EchoMAV/docs/docs/index.md

# EchoMAV Documentation

Welcome to the EchoPilot AI Technical Library. Please find the quick links below to get started:

**[EchoPilot AI Hardware Overview](echopilot_ai.md)**  

**[Building ArduPilot for the EchoPilot AI](build_ardupilot.md)**

**[Building PX4 for the EchoPilot AI](build_px4.md)**

**[Building L4T (Orin NX or Orin Nano) for the EchoPilot AI](compile_l4t_orin.md)**

**[Building L4T (Xavier NX) for the EchoPilot AI](compile_l4t.md)**

**[Building L4T (Nano) for the EchoPilot AI](compile_l4t_nano.md)**
