EchoMAV/docs/docs/ap_simulator.md

## How to set up an Ardupilot simulator

### If you are running on windows, you will first need to install WSL1 (Windows Subsystem for Linux version 1)

Click Start, type PowerShell, and then right click "PowerShell" and "Run As Administrator"
```
dism.exe /online /enable-feature /featurename:Microsoft-Windows-Subsystem-Linux /all /norestart
```
Restart your system

Open PowerShell again
```
wsl --set-default-version 1
wsl --install -d Ubuntu-20.04
```

Once installation completes, you should be able to run Ubuntu, Click Start, type Ubuntu, and then click Ubuntu on Windows. The first time it runs you will create a username and password to use withing Ubuntu. The instructions below pick up at the point you have a command prompt.

### Install Ardupilot and run the simulator

Get prereqs:
```
sudo apt-get update
sudo apt-get install git
sudo apt-get install gitk git-gui
```
Clone repo:
```
git clone https://github.com/ArduPilot/ardupilot.git
cd ardupilot
git checkout Plane-4.3.1
git submodule update --init --recursive
```
Set up build environment:
```
Tools/environment_install/install-prereqs-ubuntu.sh -y
```
Reload the path:
```
. ~/.profile
```
Run the simulator, which will build the code the first time:
```
cd ArduPlane
../Tools/autotest/sim_vehicle.py -j4 -f quadplane
```
Once the simulator is built and running (it will take several minutes the first time you do it), you will need to set 2 key parameters by typing the following:
```
param set Q_MAV_TYPE 20
param set BRD_SERIAL_NUM 4097
```
At this point, you have ArduPlane 4.3.1 running and it will by default open a port on localhost:14550. Run the GCS and it should automatically connect to the simulator. Windows may ask you for permission to open the port, be sure and ALLOW the connection.

You may stop the simulator using ```Ctrl-C```  
#### Be sure the simulator is not running before connecting to an actual vehicle

## If you to start up the simulator at a custom location
You will need to edit the /Tools/autotest/locations.txt file  
If the simulator is running, stop it and exit using ```Ctrl-C```  
Install a simple text editor called `nano` using:
```
sudo apt-get install nano
```
Edit the `locations.txt` file
```
nano ~/ardupilot/Tools/autotest/locations.txt
```
use the arrow keys to scroll down and add a new entry:
```
NAME=Lat,Lon,Altitude,0
```
Lat and Lon are decimal degrees, altitude is meters above sea level. I'm not sure what the last 0 is for, so just leave it 0. For example, Knoxville would be:
```
Knoxville=35.92310,-84.22301,900,0
```
Save the file and exit
```
Ctrl-o <enter>
Ctrl-x
```
You may now start the simulator specifying the name of your new location
```
cd ~/ardupilot/ArduPlane
../Tools/autotest/sim_vehicle.py -j4 -f quadplane -L <YOUR LOCATION>
```
For example, to start the Knoxville location would be 
```
../Tools/autotest/sim_vehicle.py -j4 -f quadplane -L Knoxville
```
