EchoMAV/docs/docs/assets/carrierthermaltop.jpg

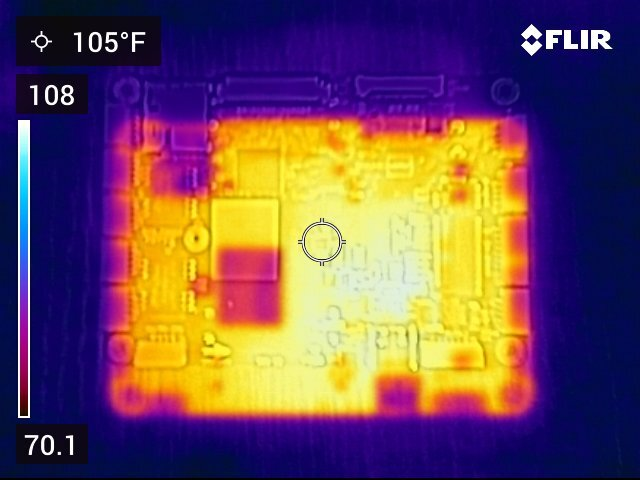
docs/assets/carrierthermaltop.jpg
