EchoMAV/docs/docs/assets/mk1fan.jpg

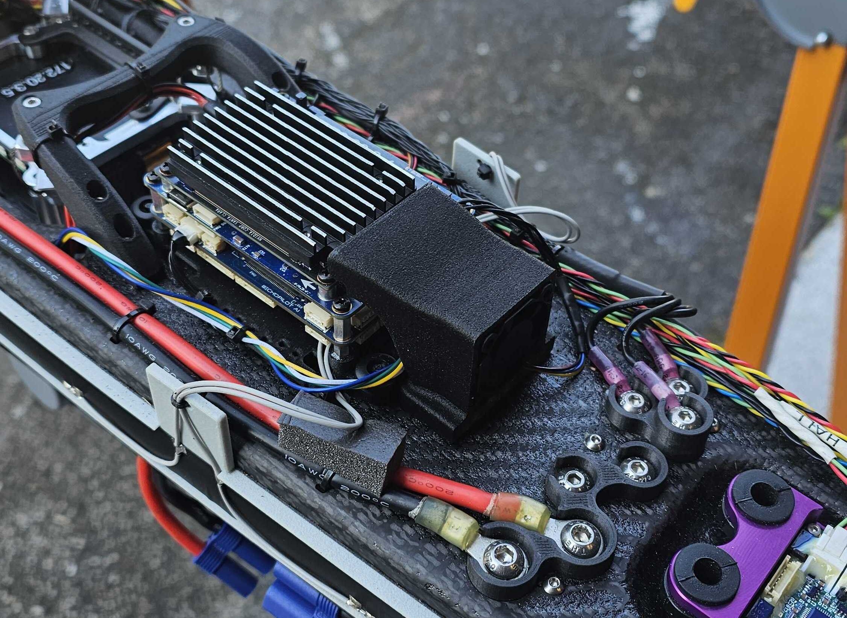
docs/assets/mk1fan.jpg
