EchoMAV/docs/docs/assets/thermalbottom.jpg

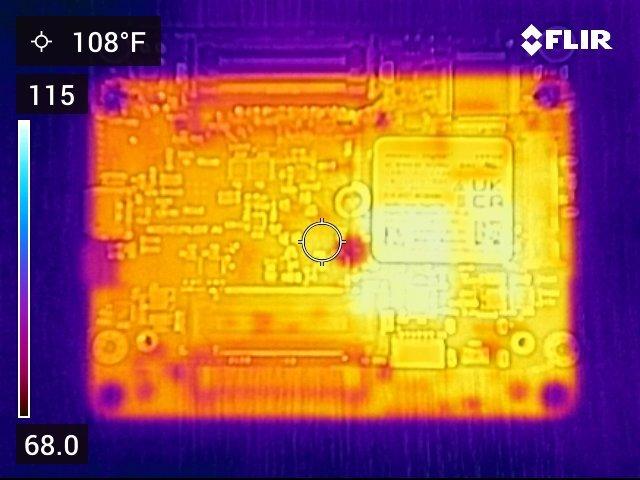
docs/assets/thermalbottom.jpg
