EchoMAV/docs/docs/assets/thermaltop.jpg

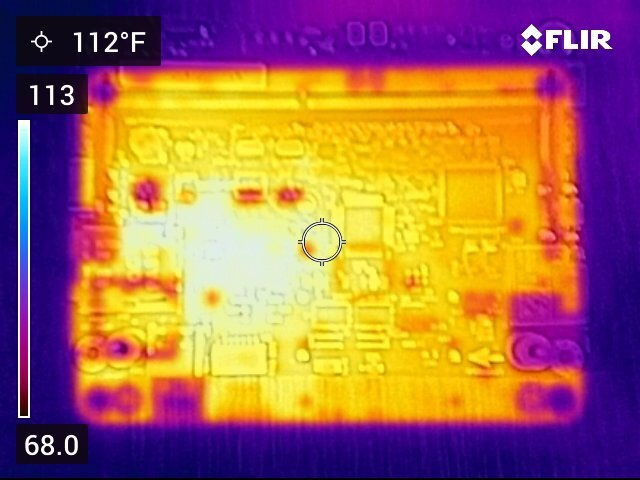
docs/assets/thermaltop.jpg
