EchoMAV/docs/docs/assets/PWM_BREAKOUT.step

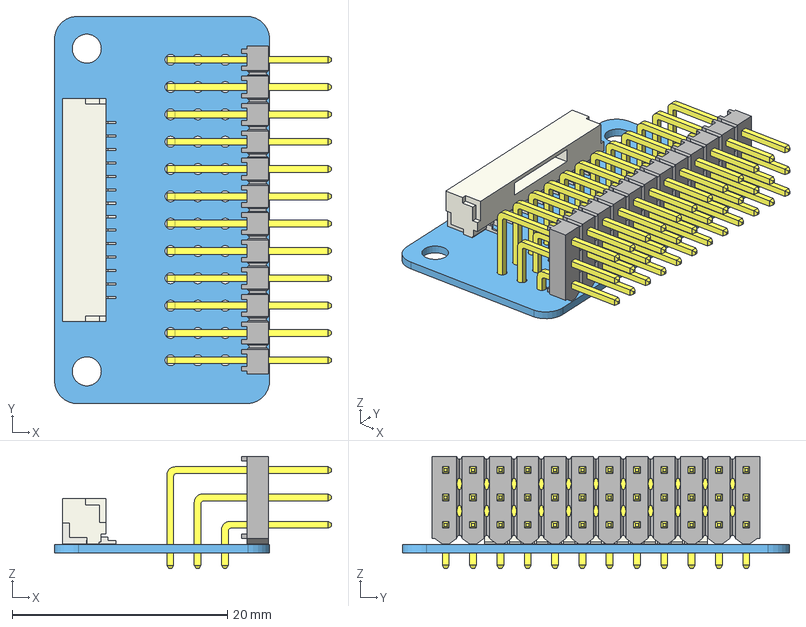
[picture p27: CAD file, 2026-07-28]
docs/assets/PWM_BREAKOUT.step
25.7 x 36.0 x 10.4 mm
echopilot_pwm_breakout PCB
