EchoMAV/docs/echopilot_carrier_1c.stl

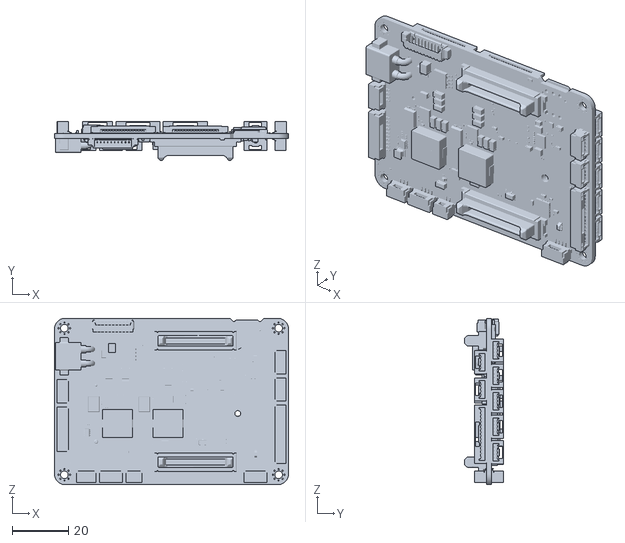
[picture p28: CAD file, 2025-11-04]
echopilot_carrier_1c.stl
83.0 x 13.8 x 59.0
