EchoMAV/docs/docs/assets/echopilot_ai.stl

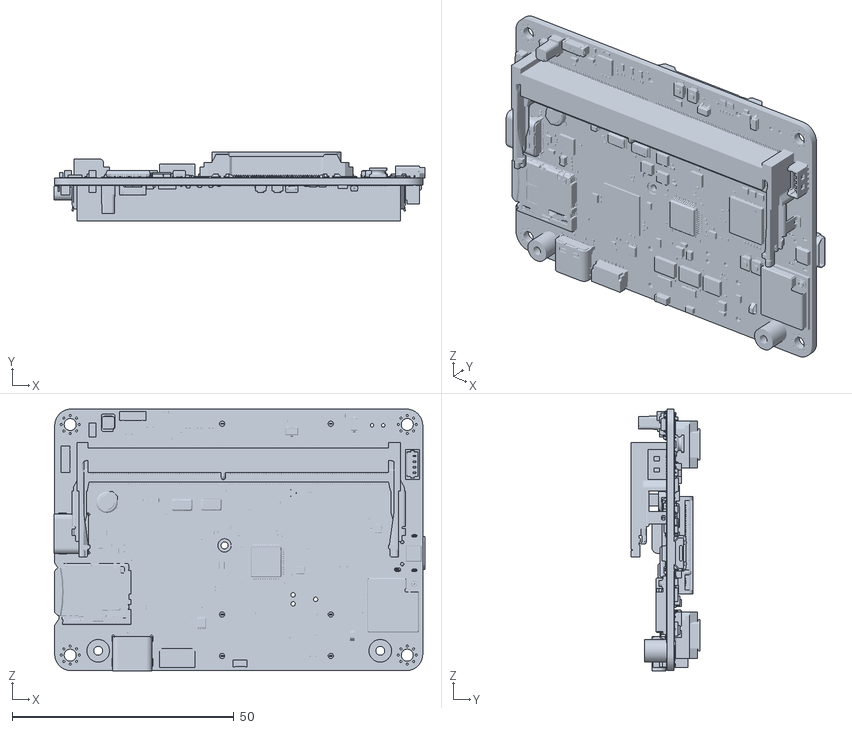
[picture p29: CAD file, 2025-11-04]
docs/assets/echopilot_ai.stl
83.6 x 15.6 x 59.1
