EchoMAV/docs/(list of files, cad)

Other CAD files:
docs/assets/echopilot_pwm_breakout.step
