EchoMAV/docs/(threads)

Thread 1 (2025-01-29):

Compile Orin NX docs instruct to download BSP sources but it is never used

nabeelsherazi, 2025-01-29:
Hi there!

I wanted to point out that the docs for compiling L4T for the Orin NX instruct to download three files:

> Next you will need to download three packages from Nvidia: [Driver Package (BSP), Sample Root Filesystem and Driver Package (BSP) Sources](https://developer.nvidia.com/embedded/jetson-linux-r3643).

But the "Driver Package (BSP) Sources" are never used. Wanted to double check that this is an error and not a missing step in the documentation.

Thank you!
