EchoMAV/docs/docs/assets/echopilot_ai_carrier_rev1d.pdf

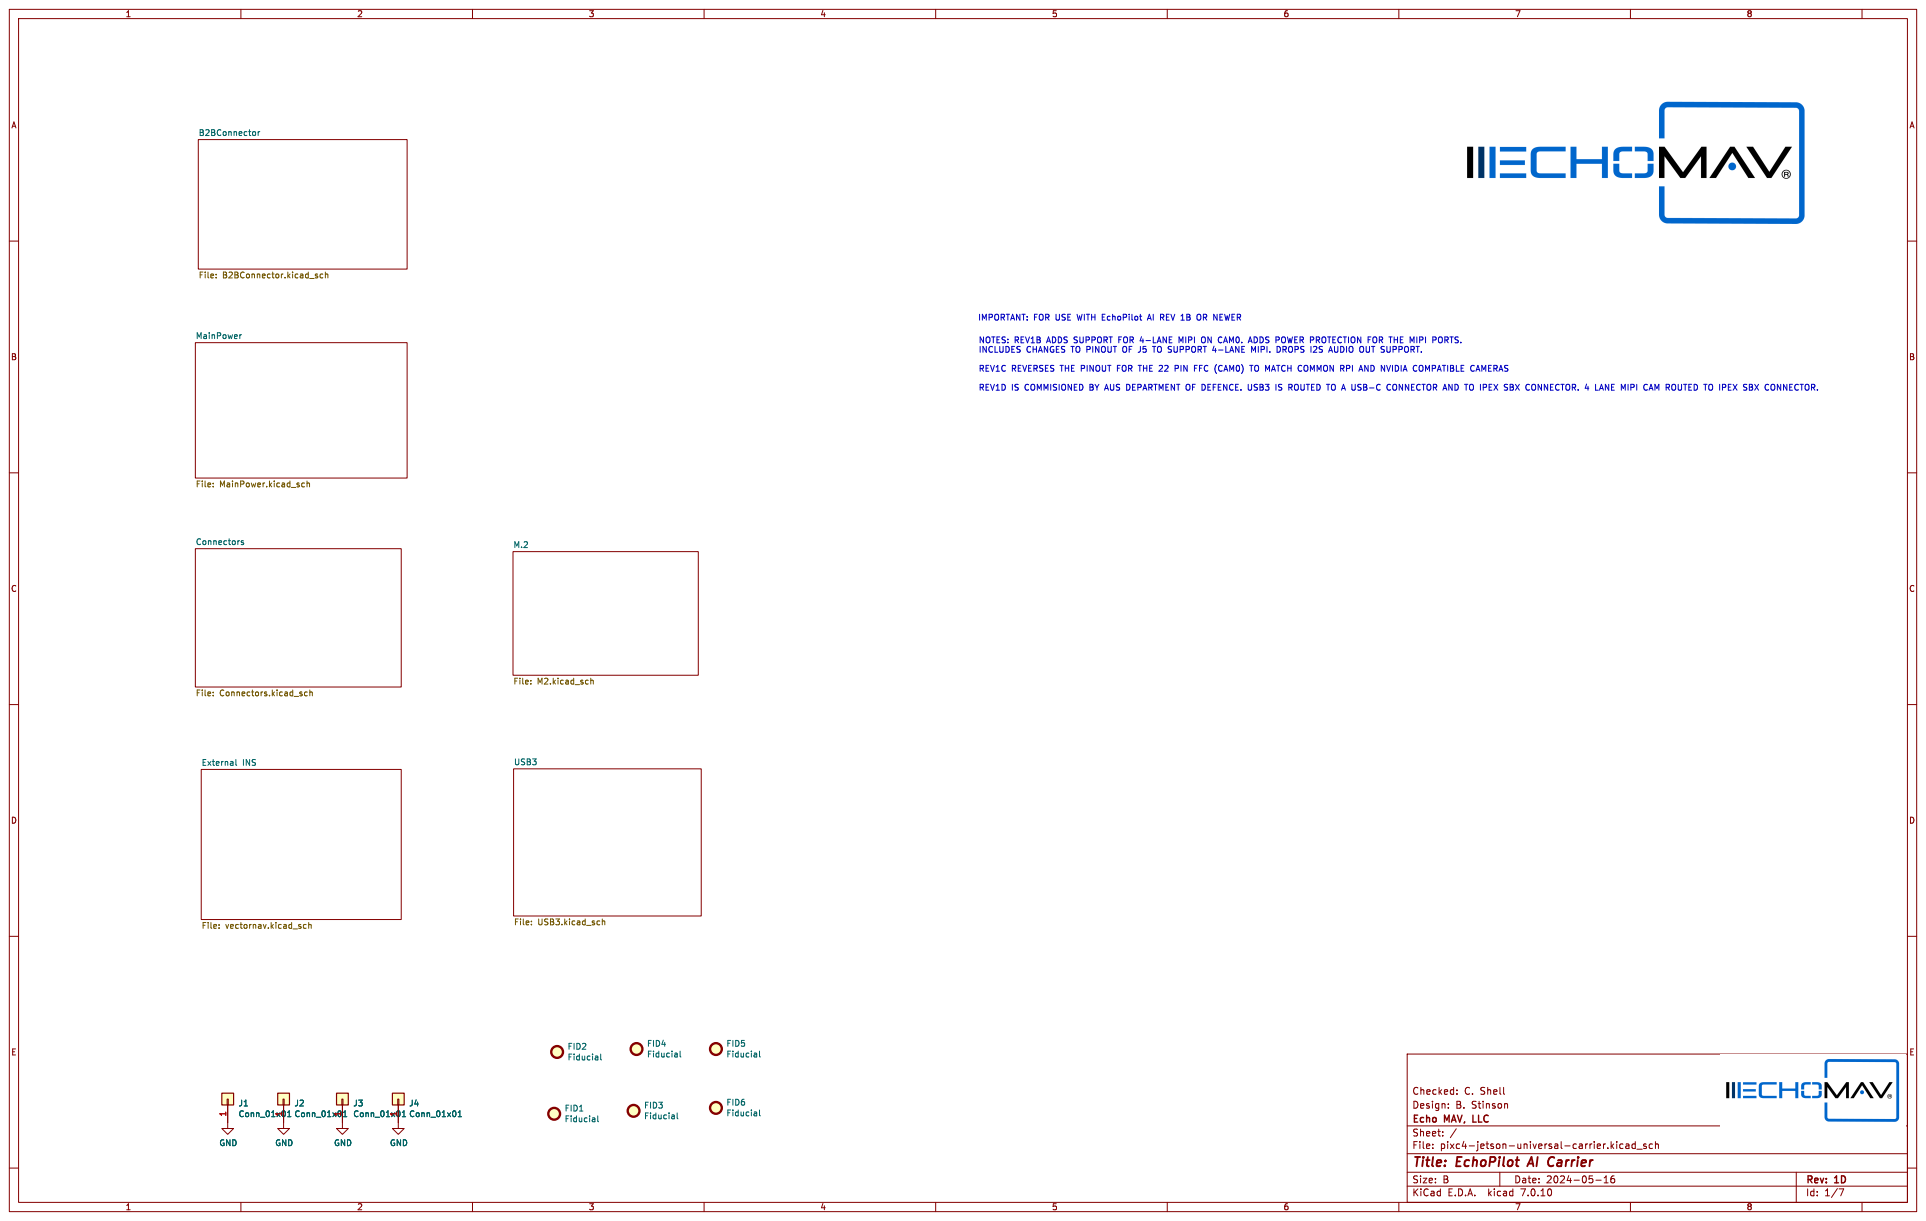
[picture p33: page 1]

B2BConnector File: B2BConnector.kicad_sch MainPower File: MainPower.kicad_sch Connectors File: Connectors.kicad_sch External INS

NOTES: REV1B ADDS SUPPORT FOR 4-LANE MIPI ON CAM0. ADDS POWER PROTECTION FOR THE MIPI PORTS.
INCLUDES CHANGES TO PINOUT OF J5 TO SUPPORT 4-LANE MIPI. DROPS I2S AUDIO OUT SUPPORT. REV1C REVERSES THE PINOUT FOR THE 22 PIN FFC (CAM0) TO MATCH COMMON RPI AND NVIDIA COMPATIBLE CAMERAS REV1D IS COMMISIONED BY AUS DEPARTMENT OF DEFENCE. USB3 IS ROUTED TO A USB-C CONNECTOR AND TO IPEX SBX CONNECTOR. 4 LANE MIPI CAM ROUTED TO IPEX SBX CONNECTOR.

Design: | B E.D.A. | B. Stinson Checked: C. Shell | kicad 7.0.10 Size: Rev: 1D | E Date: 2024-05-16 KiCad

MAV, LLC Id: 1/7 Title: EchoPilot AI Carrier File: pixc4-jetson-universal-carrier.kicad_sch Sheet: / Echo

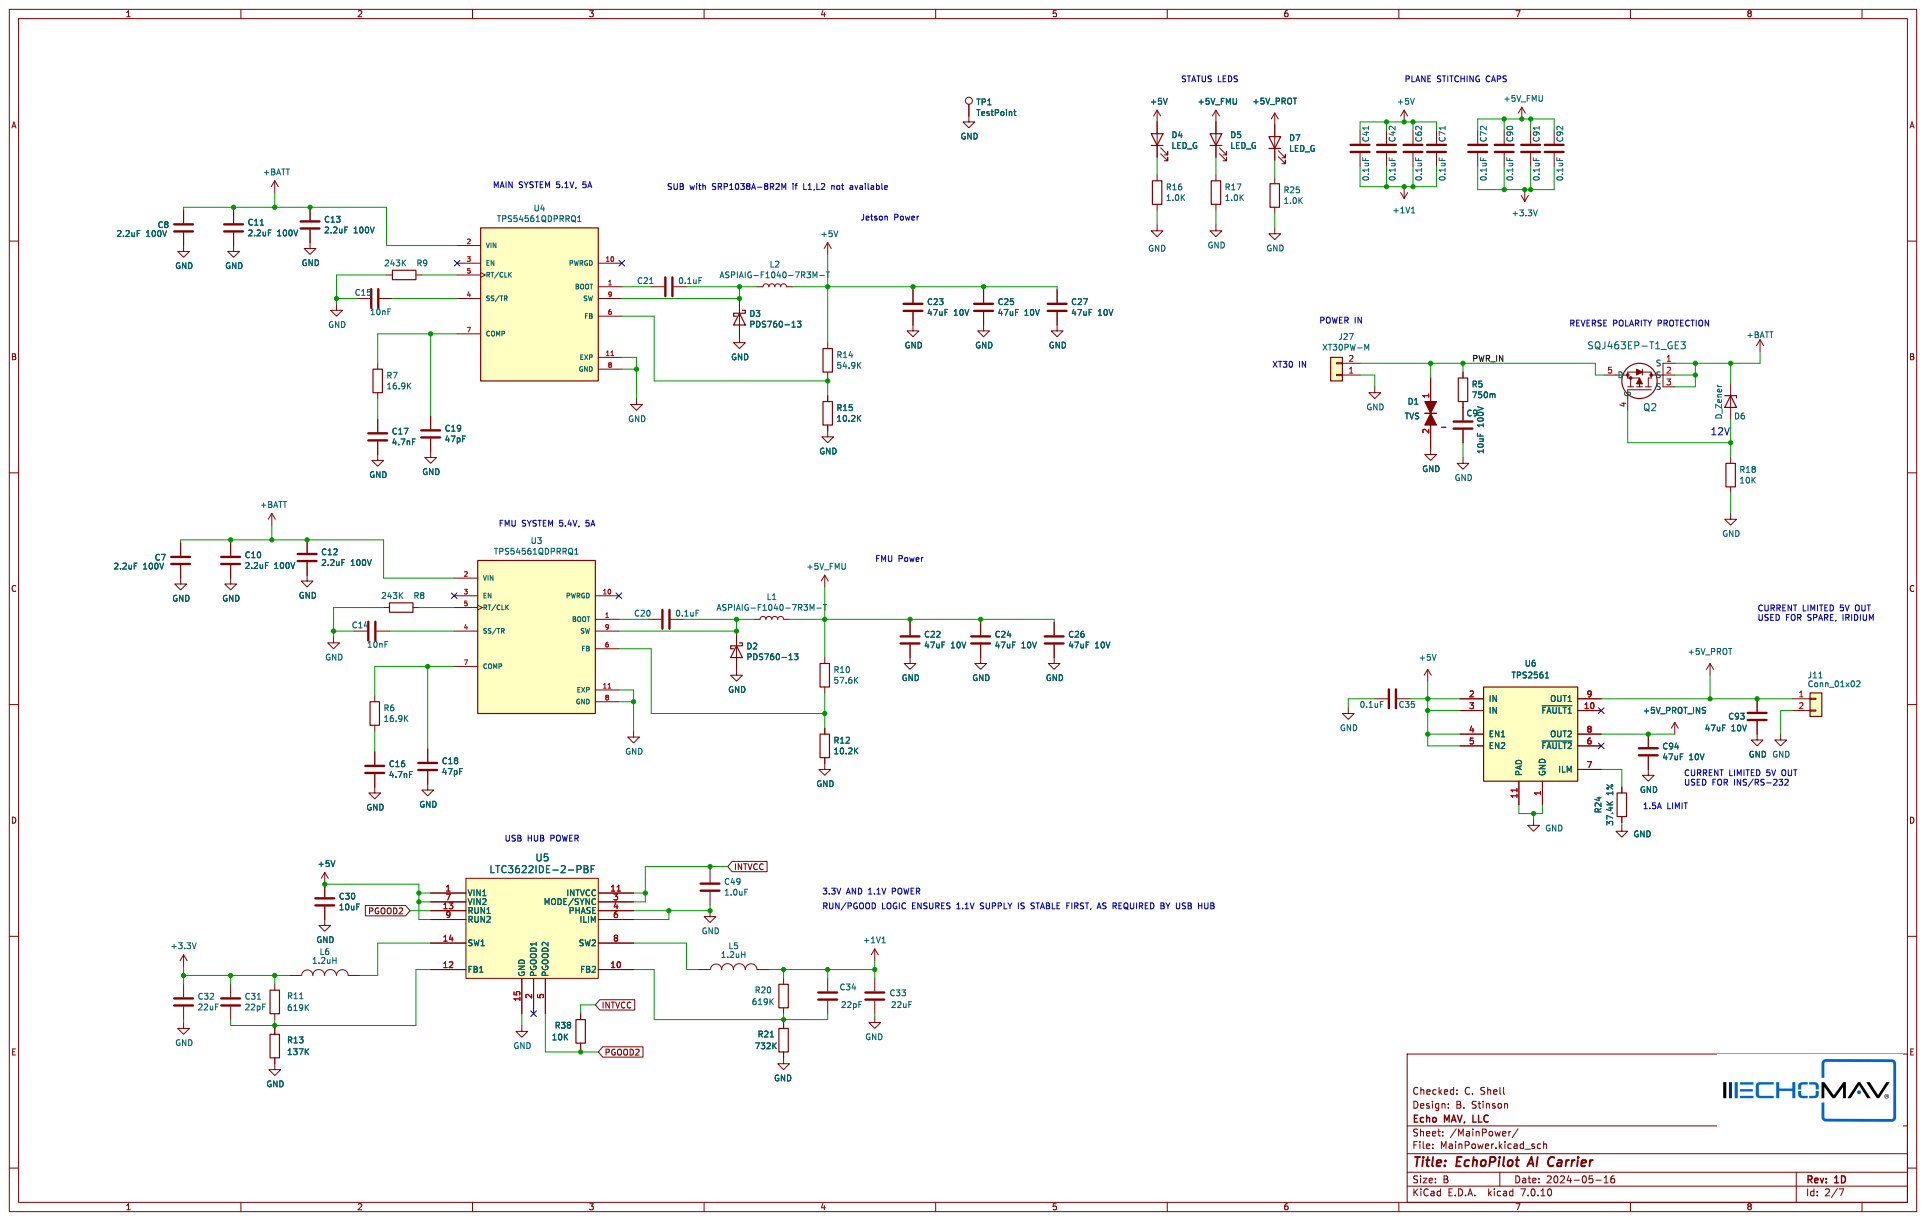
[picture p34: page 2]

3.3V AND 1.1V POWER
RUN/PGOOD LOGIC ENSURES 1.1V SUPPLY IS STABLE FIRST, AS REQUIRED BY USB HUB

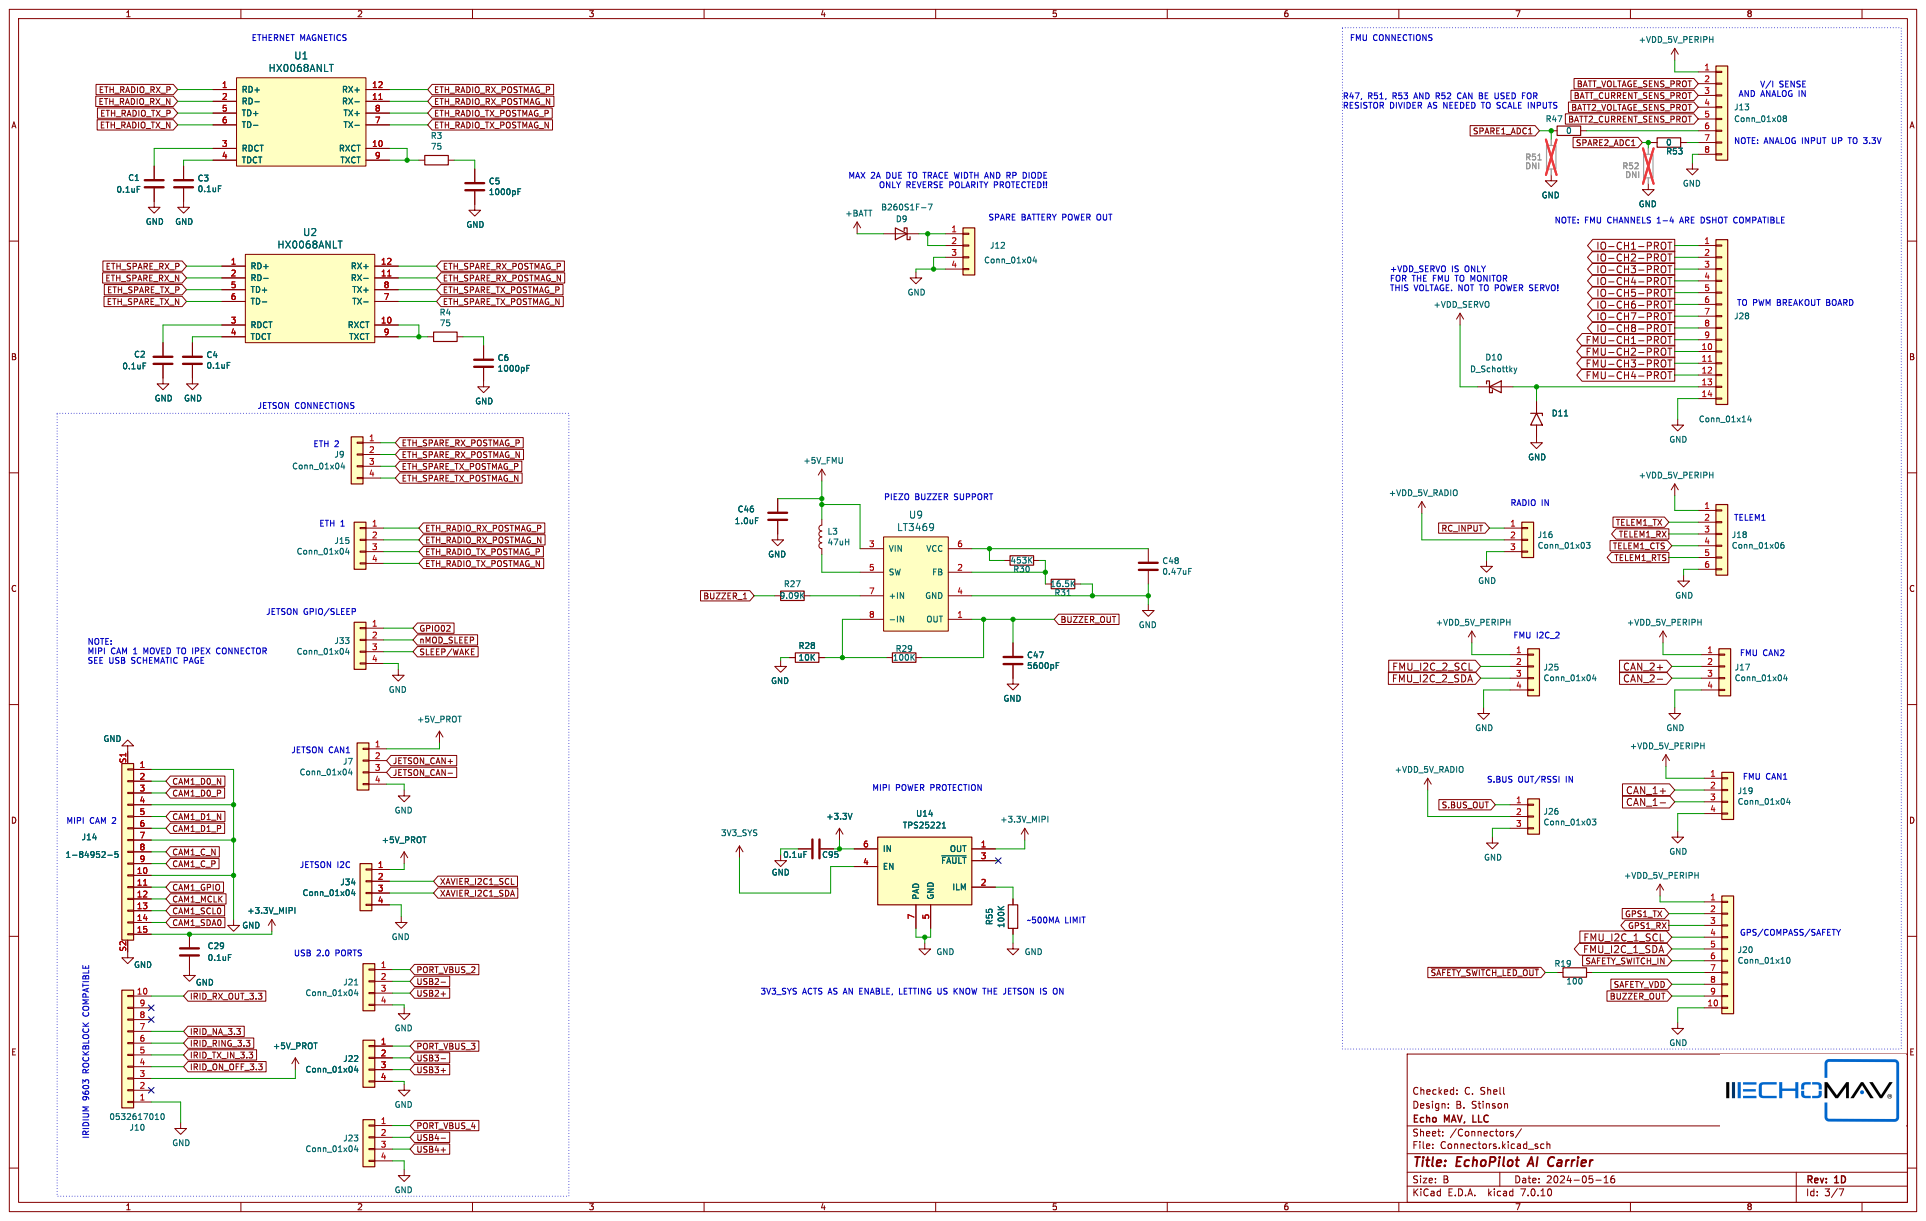
[picture p35: page 3]

RESISTOR DIVIDER AS NEEDED TO SCALE INPUTS

NOTE: ANALOG INPUT UP TO 3.3V

SPARE BATTERY POWER OUT C3

FOR THE FMU TO MONITOR

TO PWM BREAKOUT BOARD

JETSON CAN1 MIPI CAM 2 NOTE: MIPI CAM 1 MOVED TO IPEX CONNECTOR

SEE USB SCHEMATIC PAGE

~500MA LIMIT MIPI POWER PROTECTION

3V3_SYS ACTS AS AN ENABLE, LETTING US KNOW THE JETSON IS ON

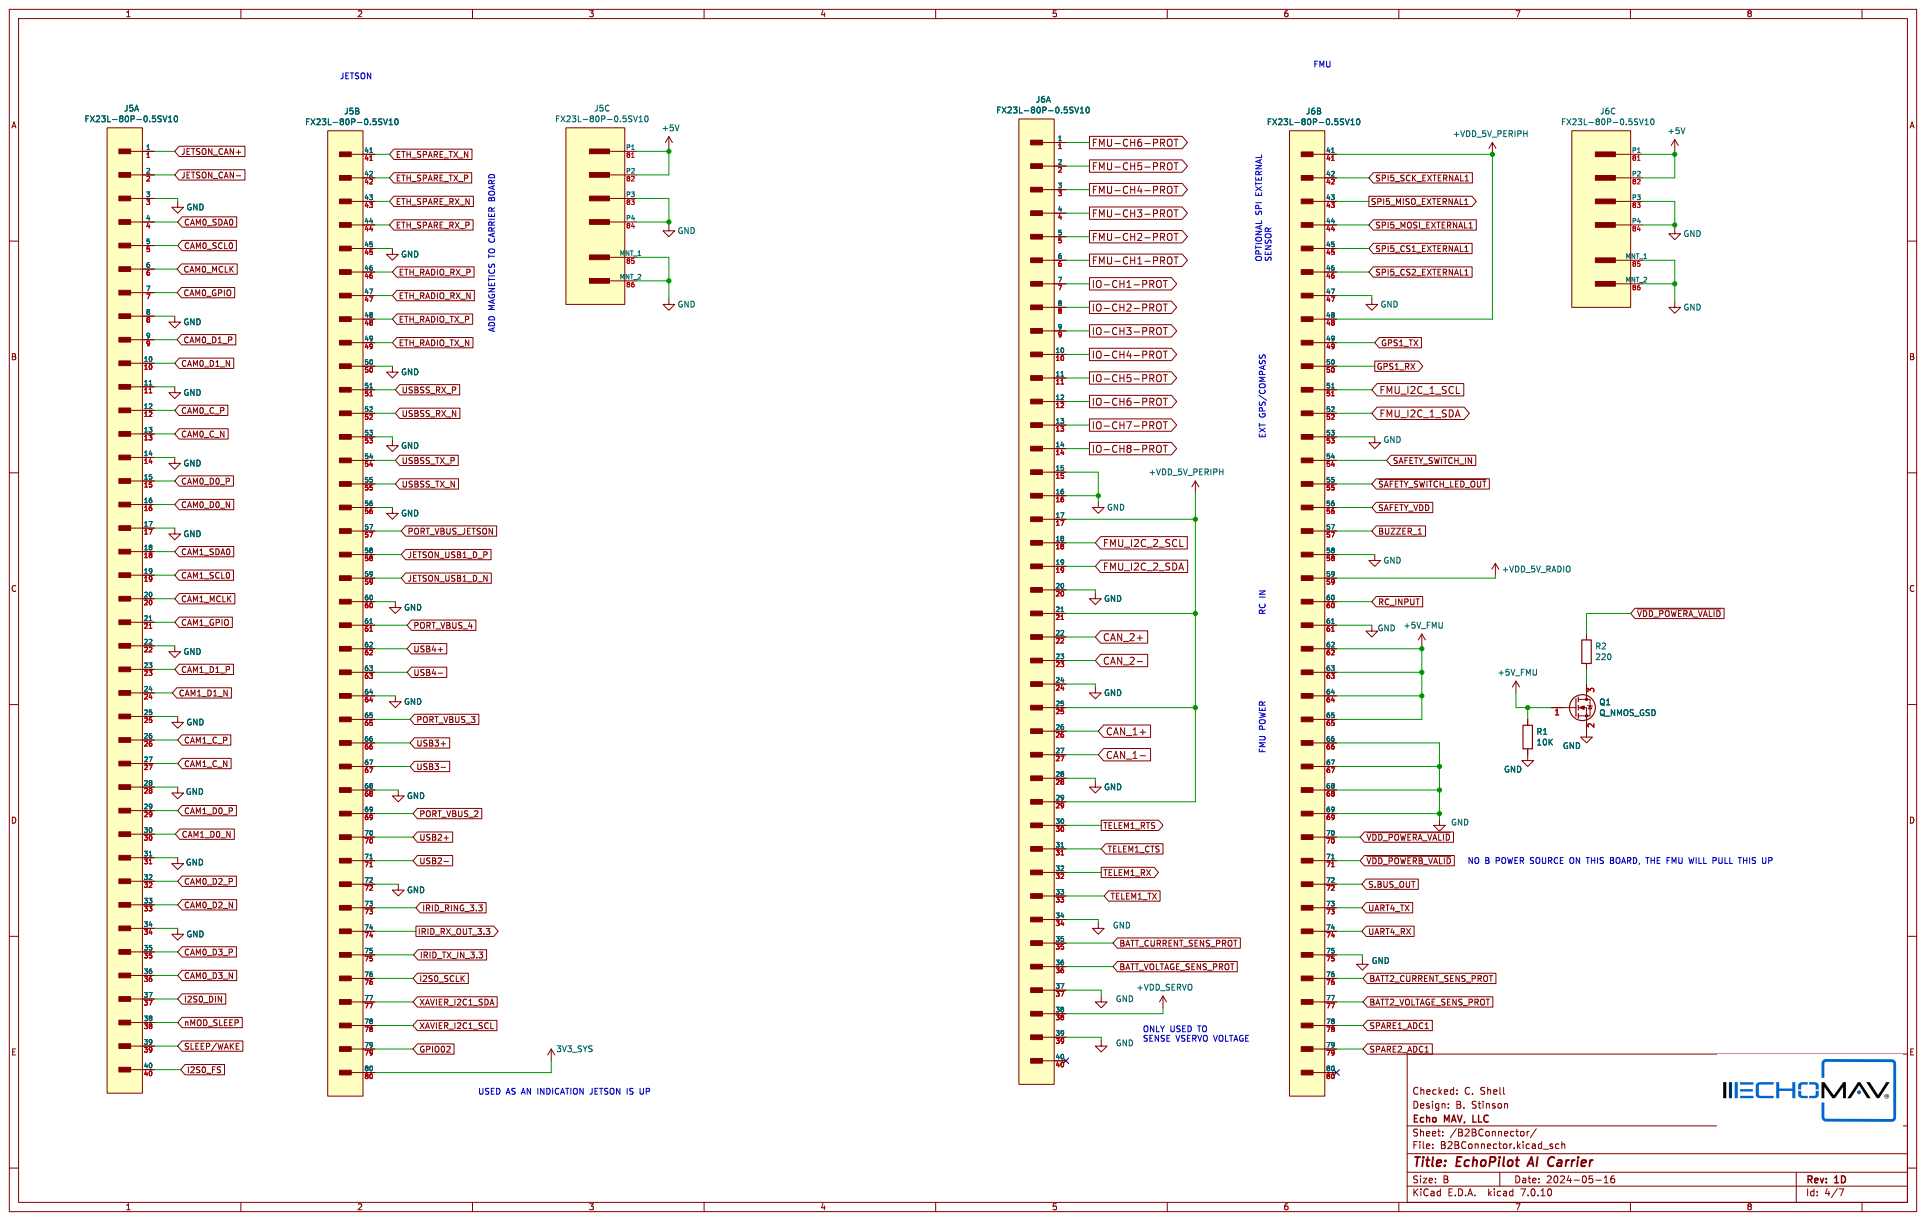
[picture p36: page 4]

+5V_FMU
SENSE VSERVO VOLTAGE FMU POWER

NO B POWER SOURCE ON THIS BOARD, THE FMU WILL PULL THIS UP

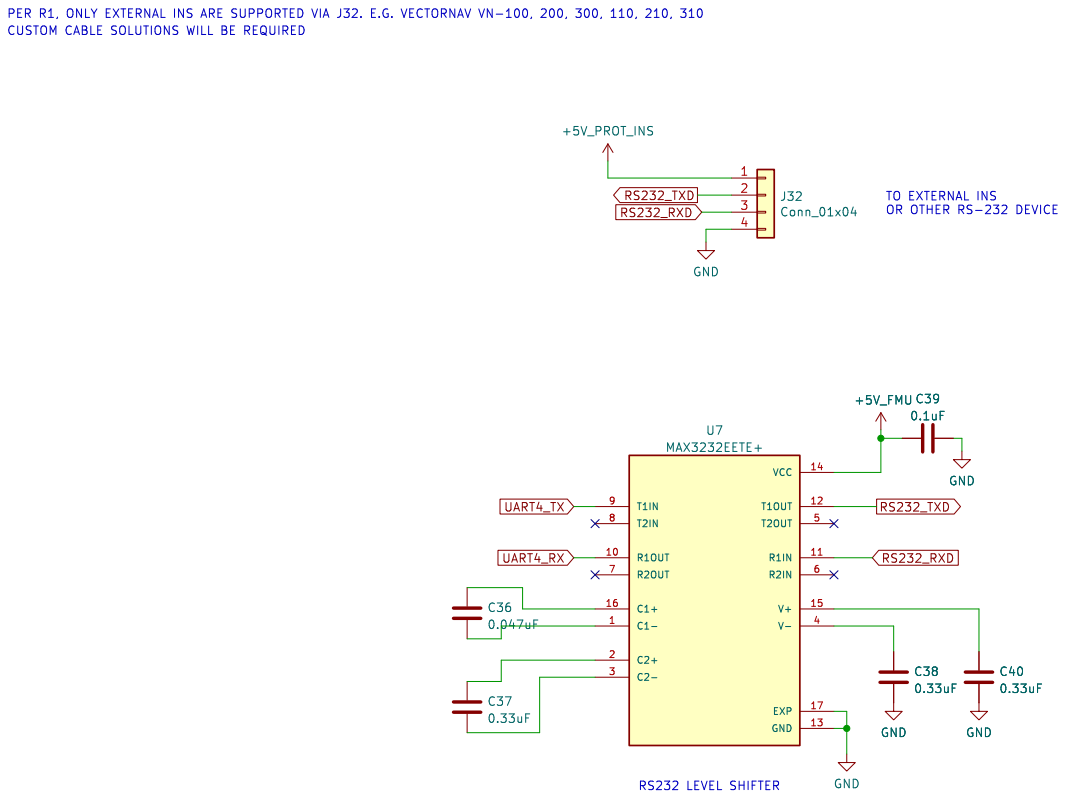
[picture p37: page 5]

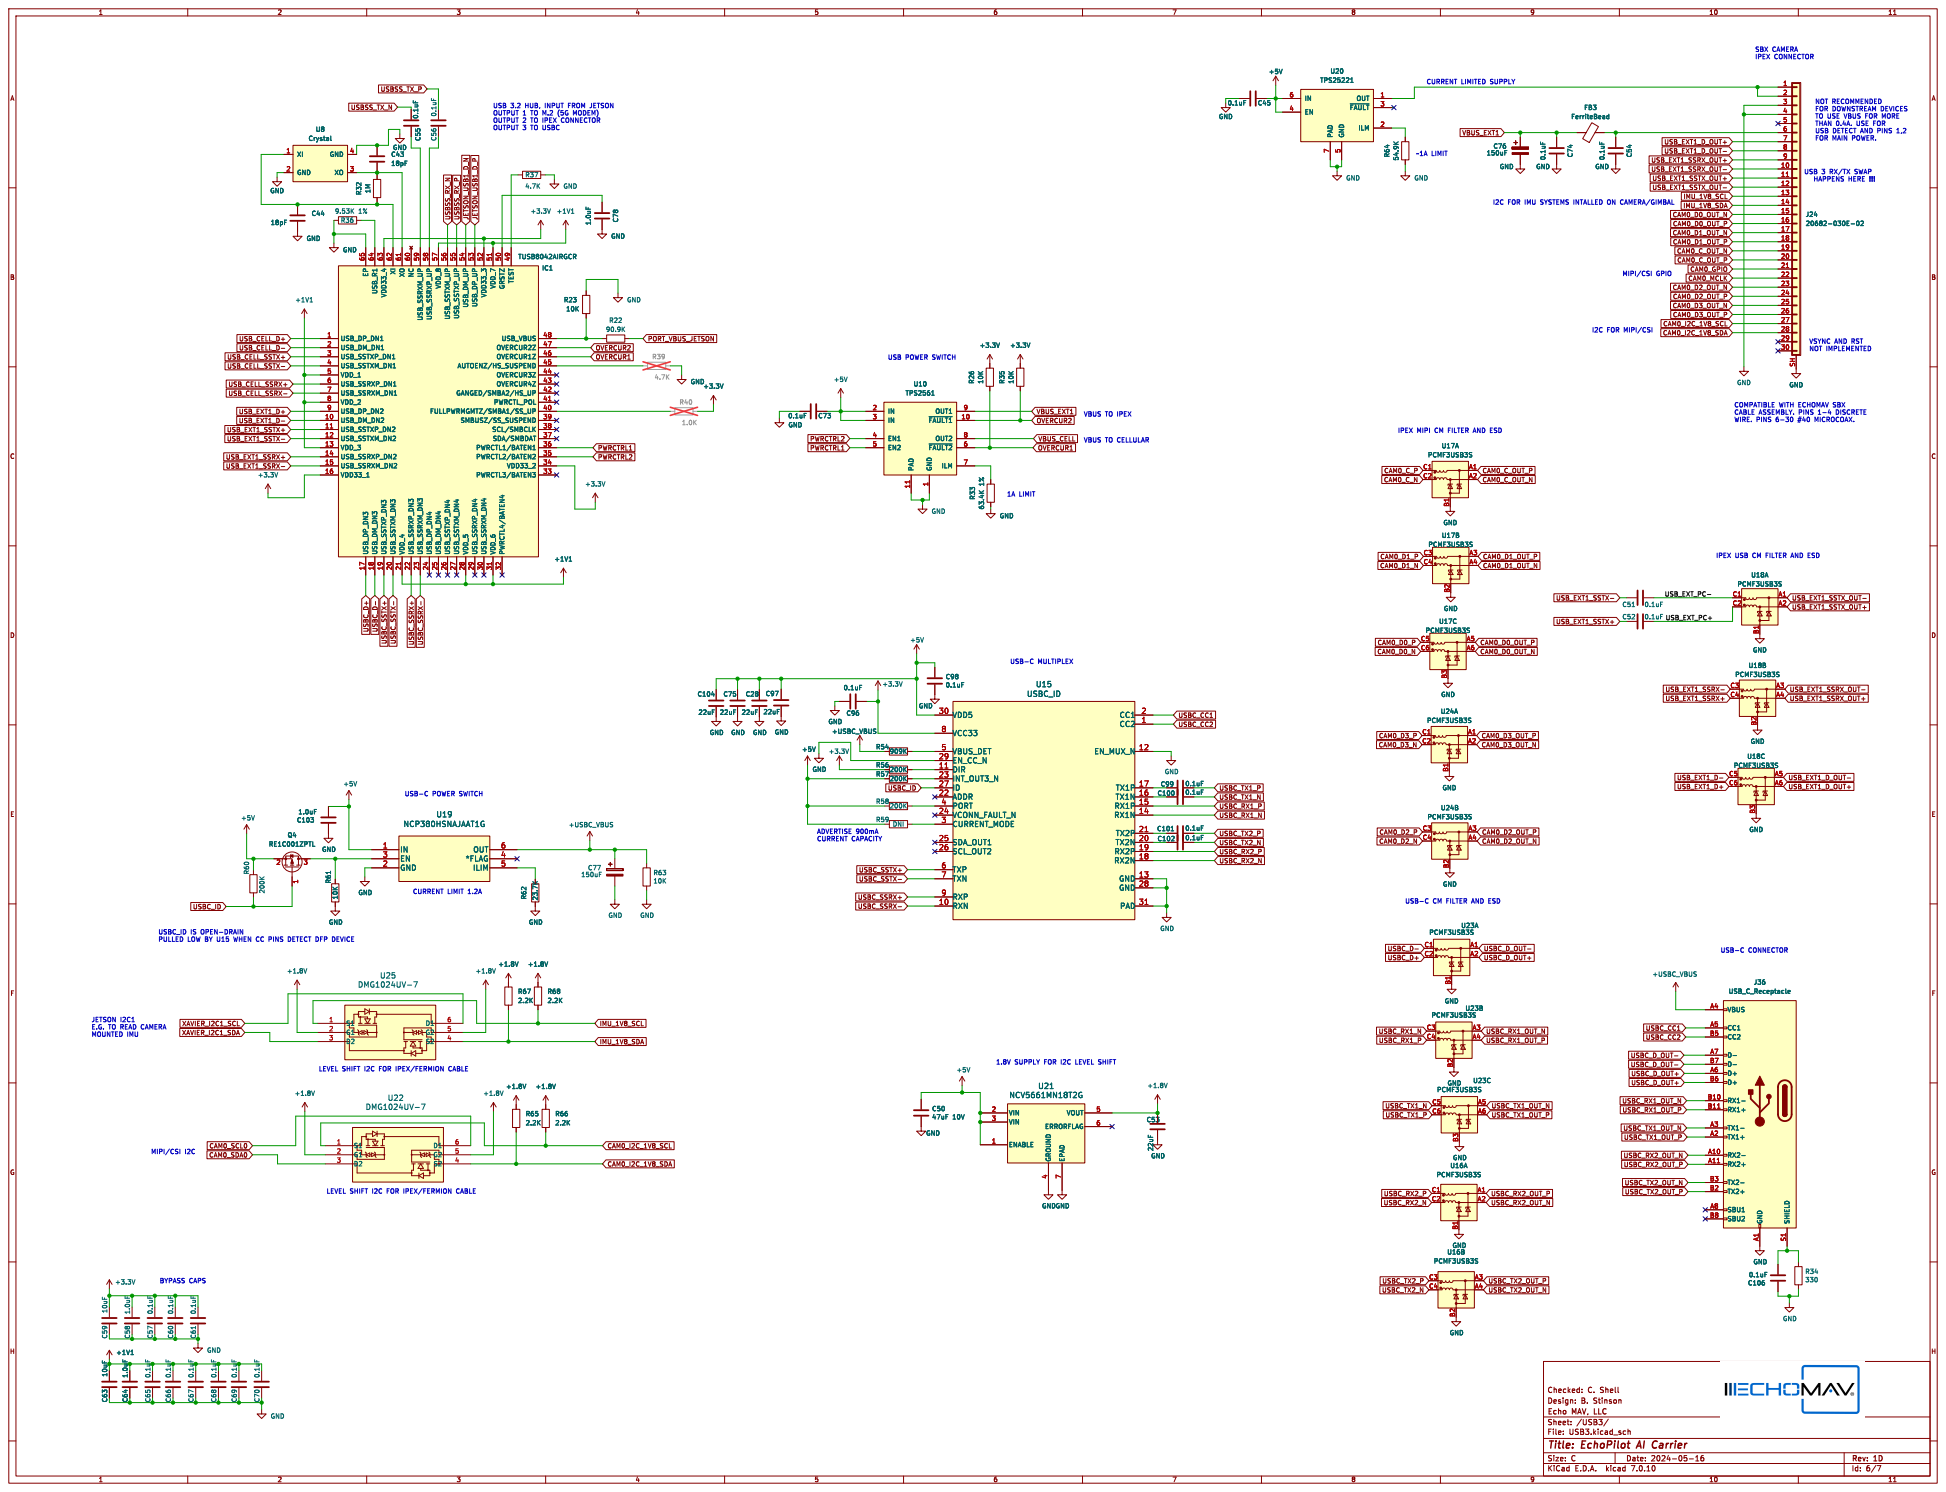
[picture p38: page 6]

I2C FOR MIPI/CSI CURRENT LIMITED SUPPLY

NOT RECOMMENDED
FOR DOWNSTREAM DEVICES
TO USE VBUS FOR MORE
THAN 0.4A. USE FOR

USB 3.2 HUB, INPUT FROM JETSON OUTPUT 1 TO M.2 (5G MODEM) OUTPUT 2 TO IPEX CONNECTOR OUTPUT 3 TO USBC

I2C FOR IMU SYSTEMS INTALLED ON CAMERA/GIMBAL

IPEX USB CM FILTER AND ESD

USB-C CM FILTER AND ESD

USBC_ID IS OPEN-DRAIN
PULLED LOW BY U15 WHEN CC PINS DETECT DFP DEVICE

JETSON I2C1 E.G. TO READ CAMERA MOUNTED IMU

1.8V SUPPLY FOR I2C LEVEL SHIFT

LEVEL SHIFT I2C FOR IPEX/FERMION CABLE

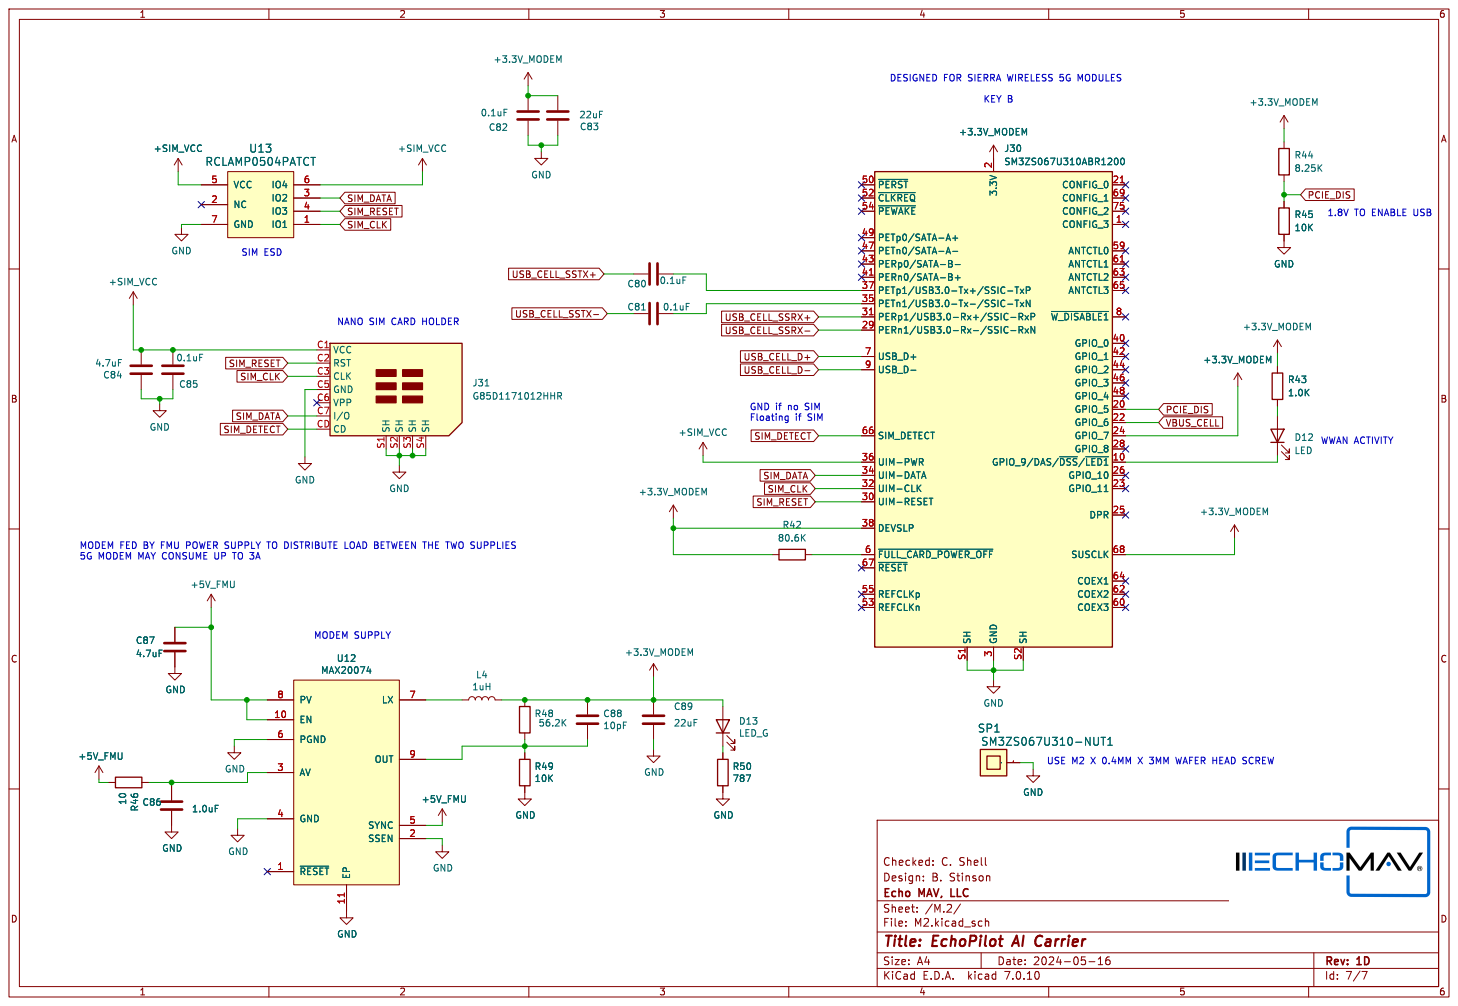
[picture p39: page 7]

2 GPIO_5 20 CONFIG_0 21 GPIO_6 22 GPIO_11 23 GPIO_7 24 DPR 25 GPIO_10 26 GPIO_8 28 PERn1/USB3.0-Rx-/SSIC-RxN 29 GND

3 UIM-RESET 30 PERp1/USB3.0-Rx+/SSIC-RxP 31 UIM-CLK 32 UIM-DATA 34 PETn1/USB3.0-Tx-/SSIC-TxN 35 UIM-PWR 36 PETp1/USB3.0-Tx+/SSIC-TxP 37 DEVSLP 38 GPIO_0 40 PERn0/SATA-B+ 41 GPIO_1 42 PERp0/SATA-B- 43 GPIO_2 44 GPIO_3 46 PETn0/SATA-A- 47 GPIO_4 48 PETp0/SATA-A+ 49 ~{PERST} 50 ~{CLKREQ} 52 REFCLKn 53

SIM ESD MODEM FED BY FMU POWER SUPPLY TO DISTRIBUTE LOAD BETWEEN THE TWO SUPPLIES

VCC C1 RST C2 CLK C3 GND C5 VPP C6

GND if no SIM
