EchoMAV/docs/(commit log)

2024-05-31 improved UART docs
2024-06-06 improved voltage/current mon
2025-01-08 carrier board Rev 1D updates
2025-01-08 add carrier 1d schematic
2025-01-16 echopilot_carrier_pinout: correct pin number
2025-02-01 update carrier board step
2025-11-04 Change 3D model download links to STL format
    Updated download links for various EchoPilot AI 3D model files to point to STL format on GitHub.
2026-06-25 Update echopilot carrier pinout documentation
    Removed introductory text and schematic section from the carrier pinout documentation.
2026-07-28 step files
    [PWM_BREAKOUT.step]
